HamPiRadio/HamPiRadio/(threads)

Thread 1 (2024-03-30):

Radio Board. Fix mixer LO low signal issue

chrisdebian, 2024-03-30:
**Describe the bug:**

The LO input is 7dBm (1.4Vpp) with the ring mixer disconnected. This must be over the frequency range 8 to 155MHz.

**Steps to reproduce:**

Disconnect the mixer LO pin. Measure with Oscilloscope (Vpp) or Spectrum Analyser (dBm). NOTE: Be aware that the scope has a highish input impedance and the SA a 50R input meaning that doing measurements can load the attenuator cursing the results. Also in my setup I have discovered my 100MHz scope probes are very low quality and once the signal is over 40MHz they attenuate a lor making them pretty useless for this measurement!

**Any thoughts on a solution to the problem?:**

Firstly, Getting an accurate measurement method is a must then ensuring the 2n3904 buffer/amplifier is suitable. It is I believe going to be ok for HF but for all frequencies I am doubting so a new design might be needed. Assistance from a good RF engineer is needed.

HamPiRadio, 2024-03-31:
Progress by Michael:
**Measurement method:** This of course has to be established first. The Spectrum Analyzer presents a 50R load to the circuit. To get an accurate measurement a quality probe is needed, and what works is a crimped SMA coax direct onto the circuit. This measure accurately using the tracking generator at  -20dBm , and also the Signal Generator set to the same.
**Requirement clarification:**  The post amplifier is driven at a high level into a Pi Attenuator that then feeds directly into the Double Balanced Mixer. I have changes the two 2N3904 devices to 2N2222a transistors (in parallel but with 12R emitter resistors) as they are higher current.  The reason for this is to reduce any noise. (Refer to the original OMEGA transceiver write-up for this).  **Results:** As of last night the 2 x 2N2222 devices are heating up!  Next to check the drive level again and the output loading...

chrisdebian, 2024-04-23:
Michael, please could you add a short status update, even if nothing has changed.

Many thanks,

Chris.

HamPiRadio, 2024-04-26:
I'm happy to. There has not been much progress recently apart from a) The work with yourself. b) Getting hampiradio.com up and running again. It is now secure. c) the radio-board-VFO thread on Discord. I have been doing a bit on this and the amp is now stable. As per the Discord thread there are a few components that need values to be decided on and a peer review or someone else to breadboard this would be great. d) the other issue (Rf Feedback) No progress as the VFO issue above MUST be sorted first. Thread on this is on Discord.
Software is stable and am very pleased with this. I will up load the UF2 soon.  Next CPU board is designed and laid out. Needs BOM and JLCPCB parts need adding and production. Front panel is also ready. The old and now removed Function rotary control are gone. Have added 3 SMD leds and removed the large hand mounted ones. They now fit on the Keypad PCB and I have found nice lenses that fit in front of the leds in the front panel.
PA and BPF boards are working fine, but I am / will be working on an iteration to manufacture them with as many smd parts as possible. Just needs time.

chrisdebian, 2024-04-26:
Hi, Michael.

Thanks for the update. On Discord, you shared some diagrams, would you be able to upload the relevant ones here? perhaps do the same for the other bug (no. 2)?

Cheers,

Chris.

HamPiRadio, 2024-04-27:
Oops, most of that update was not limited to the VFO issue! Apologies.

chrisdebian, 2024-04-27:
> Oops, most of that update was not limited to the VFO issue! Apologies.

Easily done, Michael. No worries.

Chris

HamPiRadio, 2024-04-27:
These are a copy of the pictures on Discord for this VFO thread. M
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

chrisdebian, 2024-04-27:
Thanks, Michael; that'll help the peer review.

Chris

HamPiRadio, 2024-04-28:
Morning Chris,  I uploaded the radio schematic. If you have kicad loaded you should see it, but there are some custom symbols I need to upload, so some of it won't look good. Can you check and email me corrected working on the bottom right please, about usage?Thank you.   Michael Sent from my Galaxy
-------- Original message --------From: chris_debian ***@***.***> Date: 28/04/24  11:02  (GMT+12:00) To: HamPiRadio/HamPiRadio ***@***.***> Cc: Michael Wise ***@***.***>, Assign ***@***.***> Subject: Re: [HamPiRadio/HamPiRadio] Radio Board. Fix mixer LO low signal issue (Issue #1)
Thanks, Michael; that'll help the peer review.
Chris

—Reply to this email directly, view it on GitHub, or unsubscribe.You are receiving this because you were assigned.Message ID: ***@***.***>

chrisdebian, 2024-04-28:
Hi, Michael.

I can install Kicad, but wasn't sure what you meant by "email me corrected working on the bottom right please"; could you clarify?

Thanks,

Chris

chrisdebian, 2024-04-28:
For consideration, and to be attributed if the originator would like:

"Consider replacing the 2N3904 and 2N2222A and use the BFR106.

Check out the ADE-6 for a DBM"

Thanks, P.

Chris

HamPiRadio, 2024-04-29:
Hi. The transistor is now a 2N2222a. The DBM device can either be a SBL-1 or an ADE-... device. That works well already. Thanks. MSent from my Galaxy
-------- Original message --------From: chris_debian ***@***.***> Date: 29/04/24  00:39  (GMT+12:00) To: HamPiRadio/HamPiRadio ***@***.***> Cc: Michael Wise ***@***.***>, Assign ***@***.***> Subject: Re: [HamPiRadio/HamPiRadio] Radio Board. Fix mixer LO low signal issue (Issue #1)
For consideration, and to be attributed if the originator would like:
"Consider replacing the 2N3904 and 2N2222A and use the BFR106.
Check out the ADE-6 for a DBM"
Thanks, P.
Chris

—Reply to this email directly, view it on GitHub, or unsubscribe.You are receiving this because you were assigned.Message ID: ***@***.***>

HamPiRadio, 2024-04-30:
The issue isn't the Si5351, 2N2222a or the Double Balanced Mixer.  It is getting the AMP levels correct and the attenuation matching as per my comments on Discord.

Thread 2 (2024-03-30):

Radio Board: Find / fix remaining (RF Feedback) issue.

chrisdebian, 2024-03-30:
**Describe the bug:**

RF feedback is upsetting the TX path. This is an introduced issue as it used to work well. It has been hard to chase and corner, but I believe the mixer is being overloaded in TX.

**Steps to reproduce:**

GO to TX in CW or SSB and increase TX drive, the power meter will show the transmitter ‘taking off’.

**Any thoughts on a solution to the problem?:**

Check in CW mode first and ensure the TX drive is correct into the mixer and not overloading it.

chrisdebian, 2024-04-23:
Michael, please could you add a short status update, even if nothing has changed.

Many thanks,

Chris.

HamPiRadio, 2024-04-27:
This is a copy of the picture on the Discord thread for this TX Buffer issue.
![Uploading TX pre mixer buffer.jpg…]()

Thread 4 (2024-03-31):

KiCad- Peer review of KiCad drawings

chrisdebian, 2024-03-31:
The KiCad drawings have been converted, but would benefit from peer review, to spot any potential issues.

https://docs.kicad.org/master/en/getting_started_in_kicad/getting_started_in_kicad.html#electrical_rules_check

and

https://docs.kicad.org/8.0/en/getting_started_in_kicad/getting_started_in_kicad.html#drc

Thread 13 (2024-04-23):

Add Schematics/ Gerber-type file to GitHub

chrisdebian, 2024-04-23:
Add Gerber-type files to GitHub sub-repositories (Thinking KiCad, PCBs/ Case/ enclosure drawings, etc?). What information has Michael got, that hasn’t been added/ moved to GitHub?

Thread 15 (2024-04-23):

PA Board- Check / convert to a SMD version made

chrisdebian, 2024-04-23:
1. Check / convert to a SMD version made. Create BOM &  get 5 manufactured by JLCPCB. (only hand built up to now. Some parts might change depending on availability from JLC and price. (Larger SMD parts like 2510 resistors)).

2. Decide on SMD I2Cs x 2 or leave as DIL. Probably leave as hand fit DIL as cheaper.  (LOW RISK just needs time)

Thread 19 (2024-04-23):

Case- Manufacturing

chrisdebian, 2024-04-23:
Case: Get a quantity manufactured, test design.

HamPiRadio, 2024-04-25:
The current design is workable, but it needs a very careful check to ensure all dimensions are correct before manufacturing more.  Ideas for an improved case would be good from others.

chrisdebian, 2024-04-25:
Thanks, Michael. Description updated.

Thread 20 (2024-04-23):

Add Iambic Keyer feature

chrisdebian, 2024-04-23:
Add iambic Keyer feature

#### Describe the requested feature:

Currently CW is ‘simple’. Hardware is already provided for a paddle Dit and Dah inputs to the microprocessor.

#### (If known) How would this be implemented?:

A software feature

Not in the initial release and the basic transceiver needs to be ‘a goer’. This addition is just a software enhancement. Added to Backlog.

Thread 23 (2024-04-23):

Update Si5351 drivers

chrisdebian, 2024-04-23:
Update Si5351 drivers and test

They are currently old, and there is now an Arduino library that can be used.

HamPiRadio, 2024-04-25:
All currently working fine, so this is just a nice to have to tidy things up.

chrisdebian, 2024-04-25:
Great, we could probably move this from the distant Milestone 4, to something nearer after MVP (Milestone 1). We can reassess all milestones after the initial release.

Chris.

HamPiRadio, 2024-04-26:
I agree. It's 'nice to have' and non urgent and non important. M

HamPiRadio, 2024-04-29:
It would be a dream except the minimum output frequency needs to be 8MHz + 160kHz (IF+lowest band)Si570 output frequency from 10 to 945 MHzThe SI5351 is fine I believe.  The issue is only about the VFO amp and attenuator.  It's nearly there, I'm just testing it out, and would love one or two others to breadboard it.MSent from my Galaxy
-------- Original message --------From: chris_debian ***@***.***> Date: 29/04/24  00:27  (GMT+12:00) To: HamPiRadio/HamPiRadio ***@***.***> Cc: Michael Wise ***@***.***>, Comment ***@***.***> Subject: Re: [HamPiRadio/HamPiRadio] Update Si5351 drivers (Issue #23)
Would the Si570 be a better option, than the Si5351? Pros/ cons?
Chris

—Reply to this email directly, view it on GitHub, or unsubscribe.You are receiving this because you commented.Message ID: ***@***.***>

Thread 24 (2024-04-23):

Incorporate CW Decode Software

chrisdebian, 2024-04-23:
CW decode software could be added as a feature and display CW on the TFT and / or ‘pipe it’  using USB to a host PC. This will display the received CW in plaintext ASCII as it is being received.

Thread 9 (2024-04-23):

Add HamPiRadio firmware to GitHub

chrisdebian, 2024-04-23:
Make HamPiRadio code available from GitHub. Binary/ code/ both?

Document notes, [here](https://github.com/HamPiRadio/HamPiRadio/wiki/HamPi-Firmware)?

HamPiRadio, 2024-04-26:
Are you wanting me to just attach files here Chris? If so no worries...

chrisdebian, 2024-04-26:
It would be great if the firmware could be uploaded, or binaries. This would be a huge achievement in moving the project forward. it is easy to upload, using the ['Upload' button](https://docs.github.com/en/repositories/working-with-files/managing-files/adding-a-file-to-a-repository), or perhaps from the GitHub [Desktop ](https://desktop.github.com/)app.

The project is here to help, although I know that is only me, right now, but that could change, today, and will change definitely, very soon.

Thanks,

Chris.

Thread 27 (2024-04-29):

Create editable build manual

chrisdebian, 2024-04-29:

HamPiRadio, 2024-04-30:
Currently this is a document for each board (4), and changes each time there is a new PCB. It is basic with no frills, but follow-able I think!  The Radio Board one also has instructions for setting up the software for the Radio Board (For example the IF has to be swung and set into E2PROM for the XTAL Filter frequencies, BOTH SSB & CW filters).

chrisdebian, 2024-04-30:
Hi, Michael.

yes, please upload any documentation, that you have, to the relevant part of the [Wiki](https://github.com/HamPiRadio/HamPiRadio/wiki). Please upload in an editable format, rather than a locked PDF. We can unlock a PDF, but the idea is not to discourage participation.

Thanks,

Chris.

HamPiRadio, 2024-05-04:
Upload to here? M

chrisdebian, 2024-05-04:
Hi, Michael. Could you upload to the Wiki, perhaps [here](https://github.com/HamPiRadio/HamPiRadio/wiki/Construction)?

Thanks,

Chris

Thread 28 (2024-05-01):

Document settings for QRP operation.

chrisdebian, 2024-05-01:
Many kit builders are QRP practitioners. Make it clear in the Wiki, and the Operating Manual document, how the transceiver is configured to operate QRP.

Chris.

HamPiRadio, 2024-05-01:
For any QRP builder the setup is essentially the same, but without the finals fitted.  Knowing QRP people however they can experiment and minimize the HamPiRario to any extent they like. I could only suggest! Single band, single BPF and LPF, Lower power LPF. Own case. It would be an exceptional rig as well.  I guess for any devoted QRP people the PA board can be de-featured and a lower power version created. Not a lot of work.  I can guide but not do on this one...
For people getting involved 'right now' and getting the main bits working on the bench, suggest buying the RADIO + CPU + KEYPAD boards with SMD fitted and build them. In this form the receiver will work and the TX section to the RF after the mixer. Any old BPF can be fitted by hand for listening...
