HamPiRadio/HamPiRadio/Radio_7_SM.kicad_sch

## KiCad design Radio_7_SM.kicad_sch (2024-04-28)

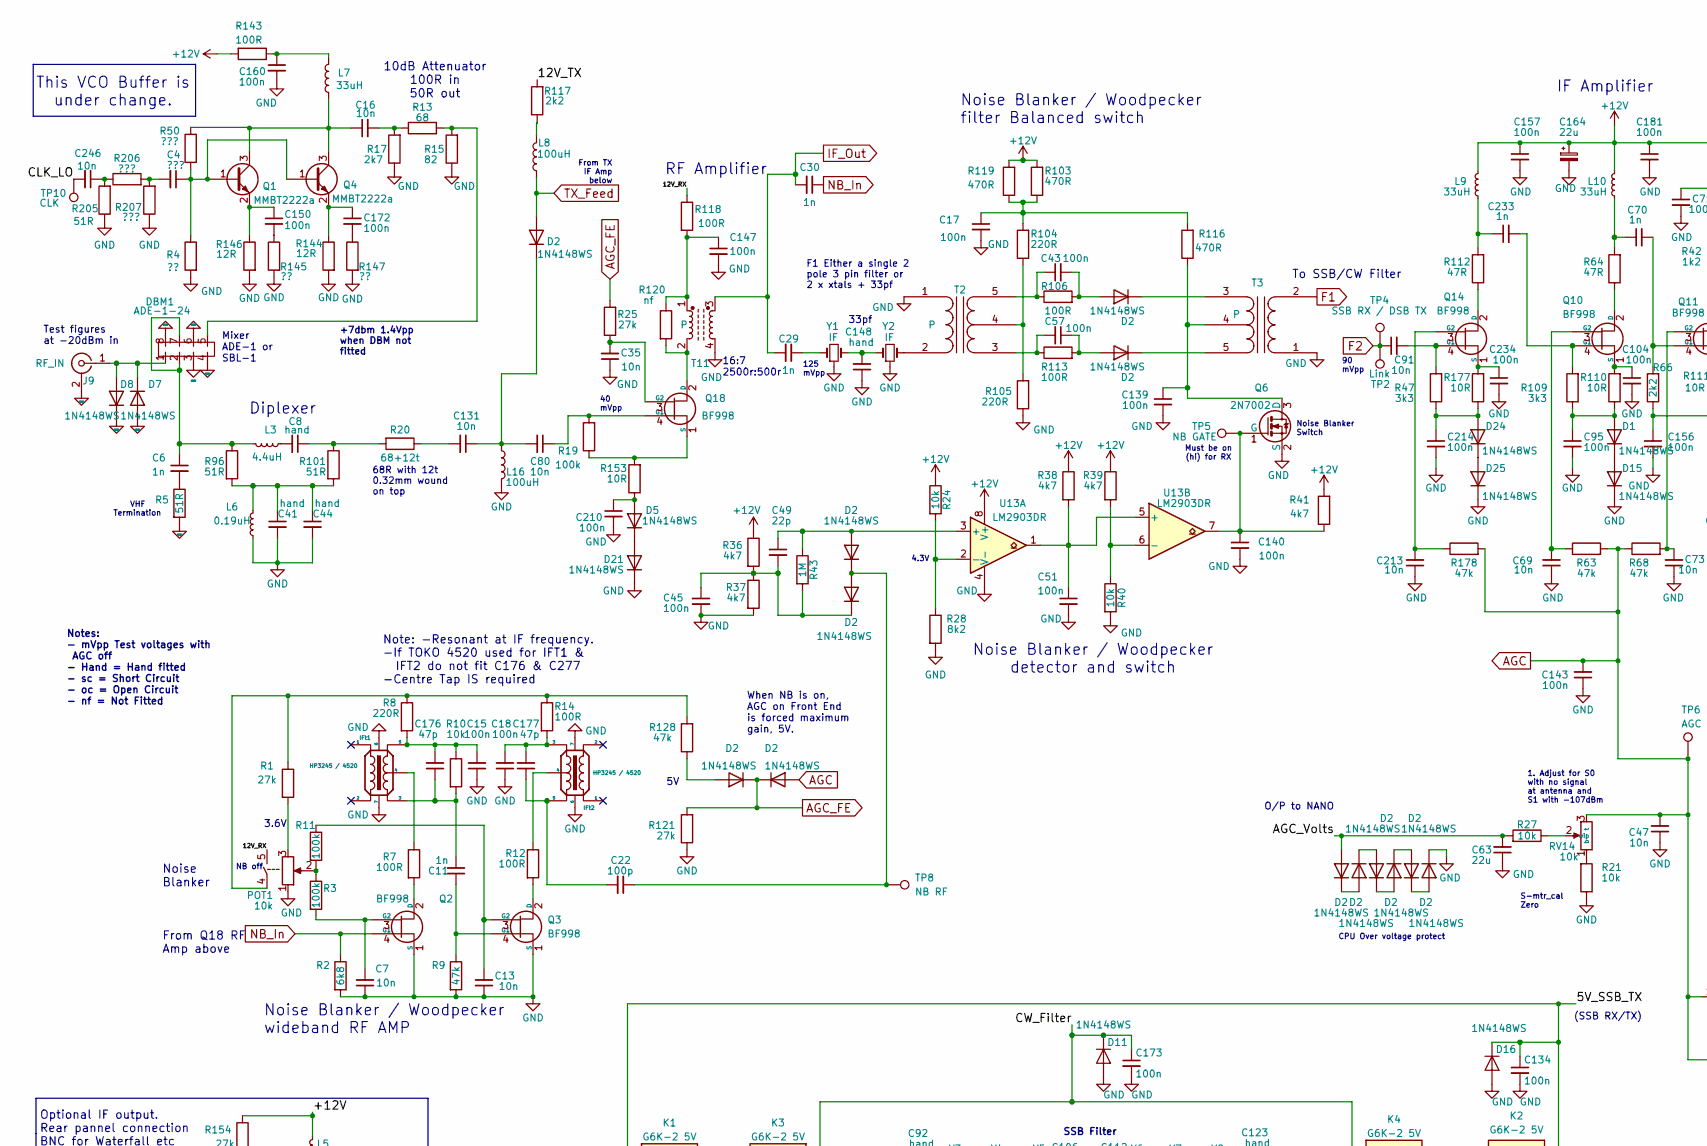
[picture p1: schematic Radio_7_SM.kicad_sch, part in row 1, column 1]

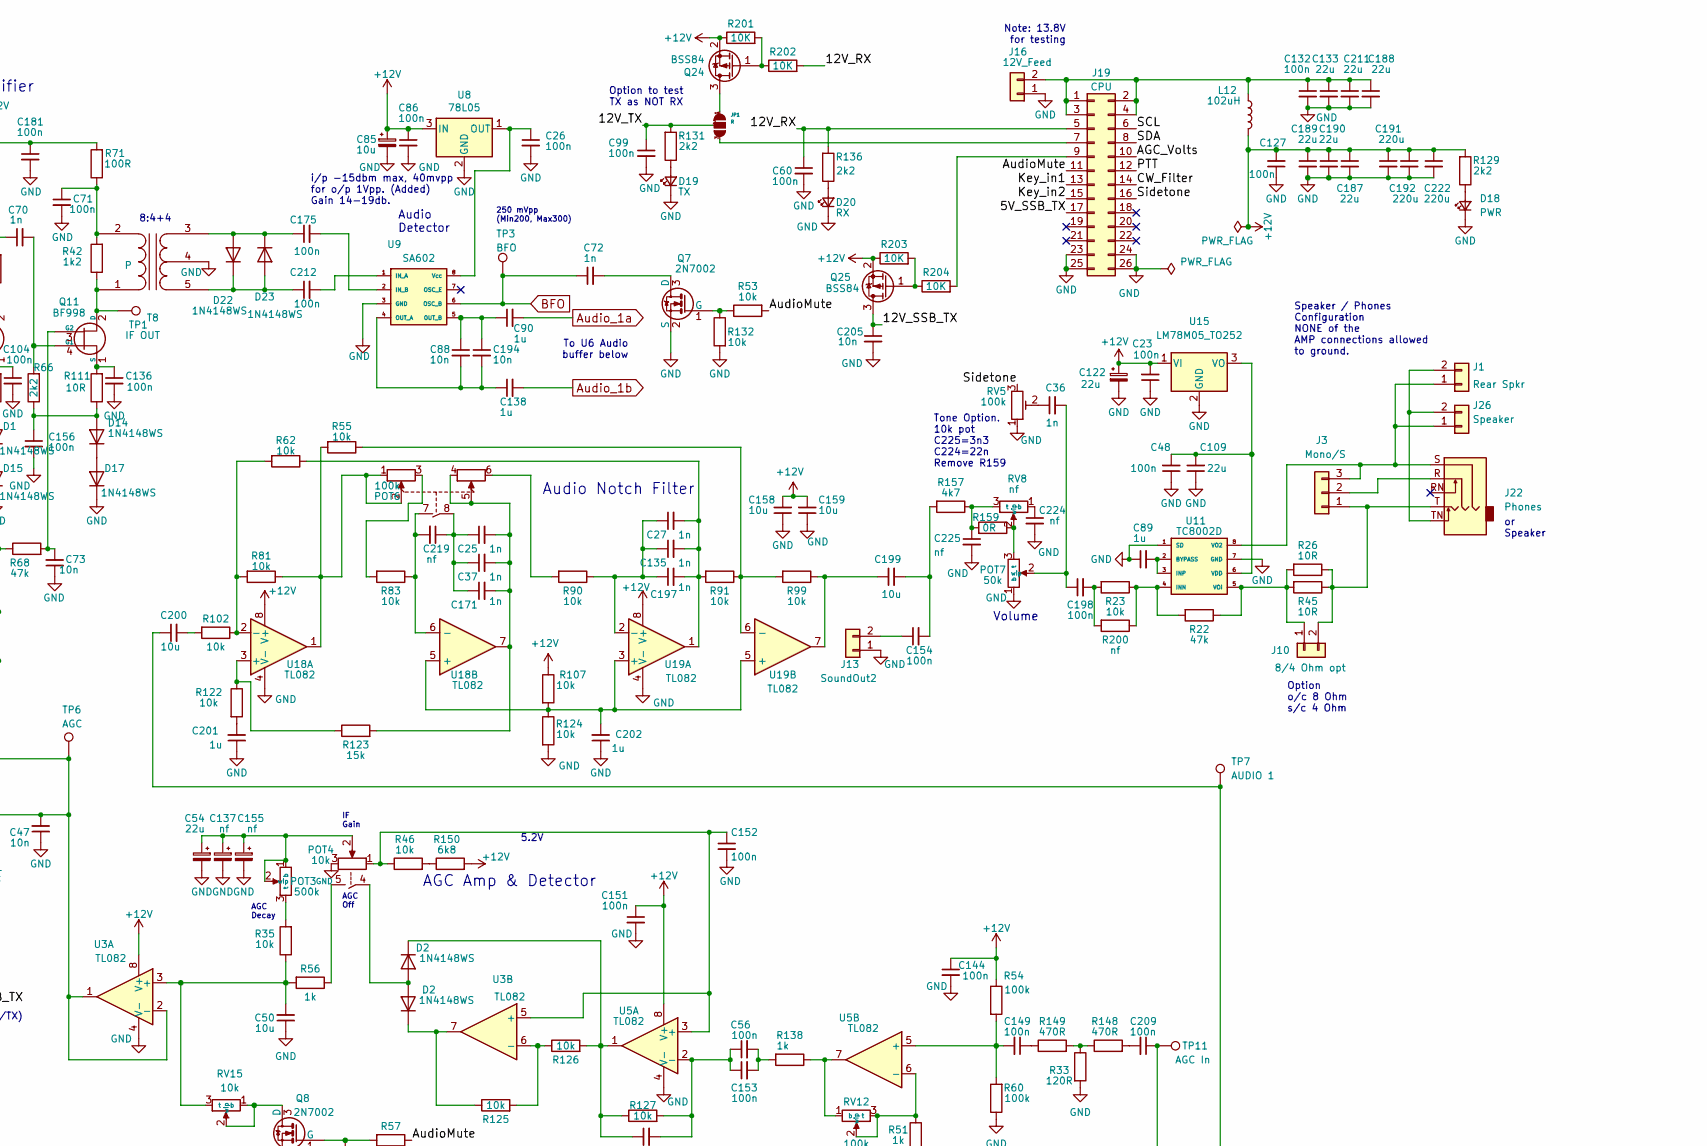
[picture p2: schematic Radio_7_SM.kicad_sch, part in row 1, column 2]

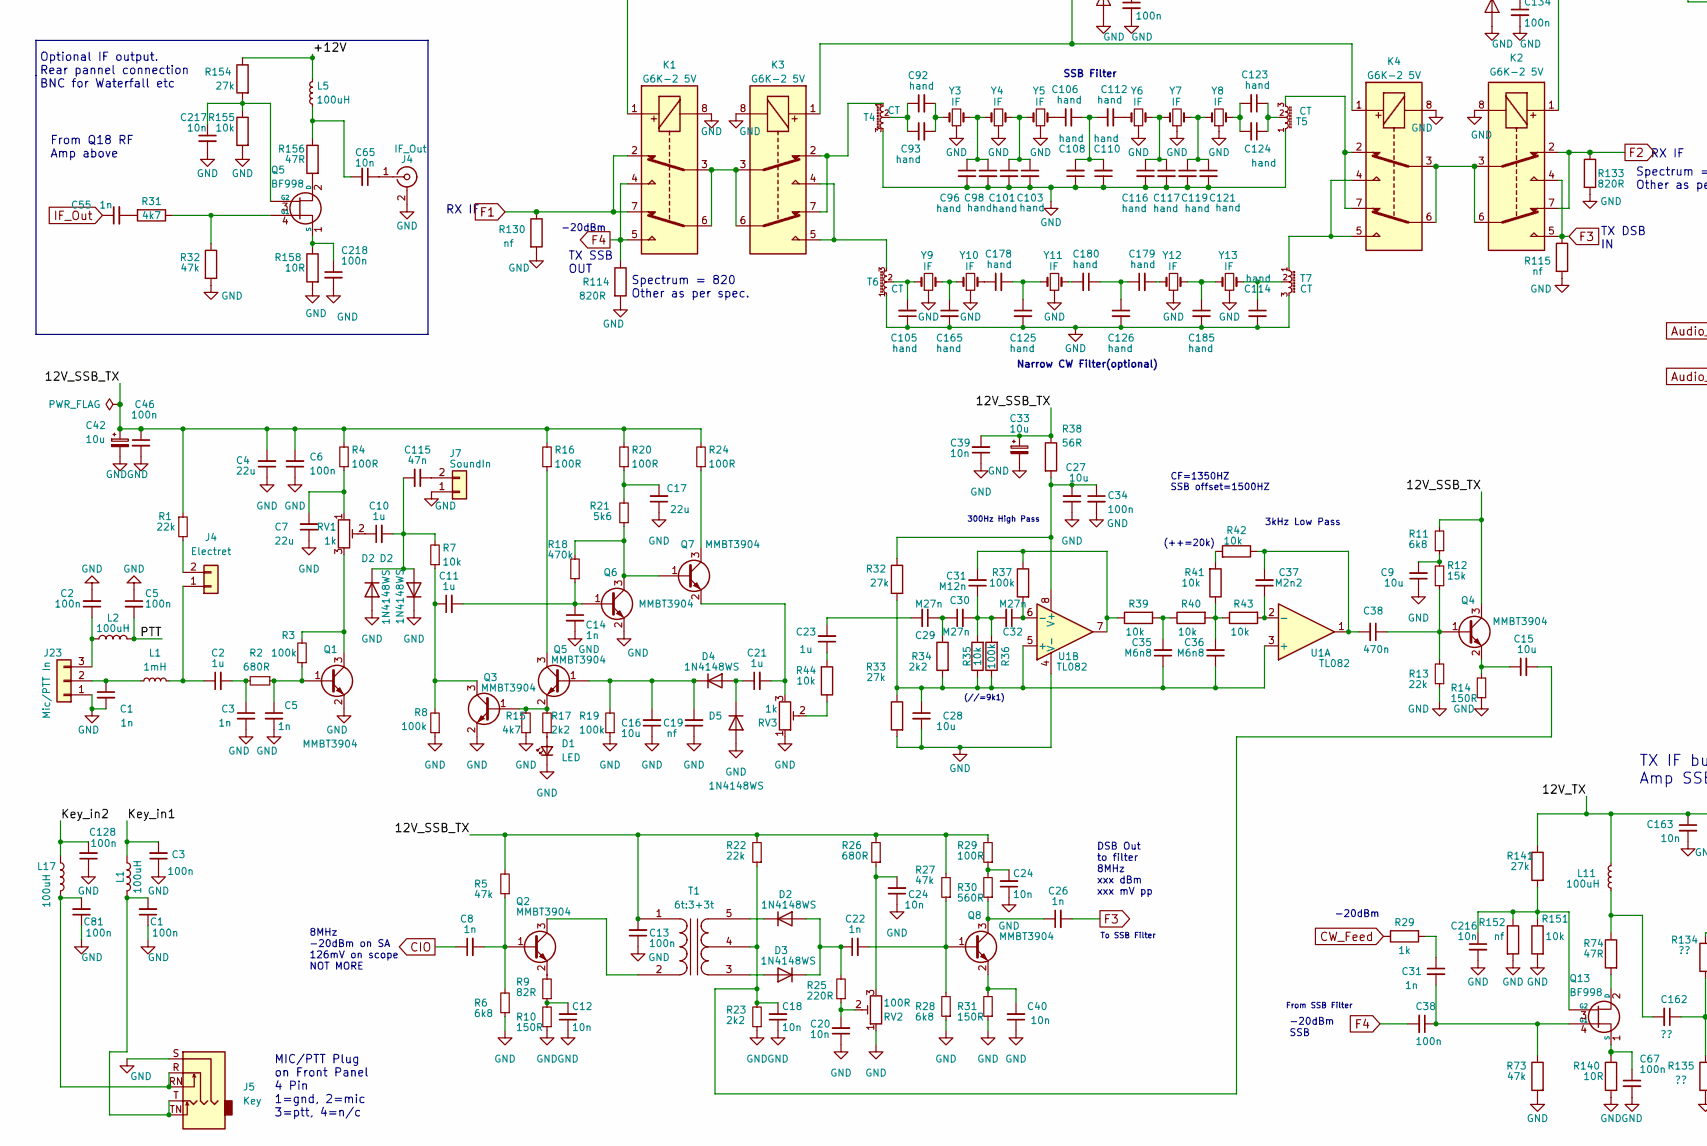
[picture p3: schematic Radio_7_SM.kicad_sch, part in row 2, column 1]

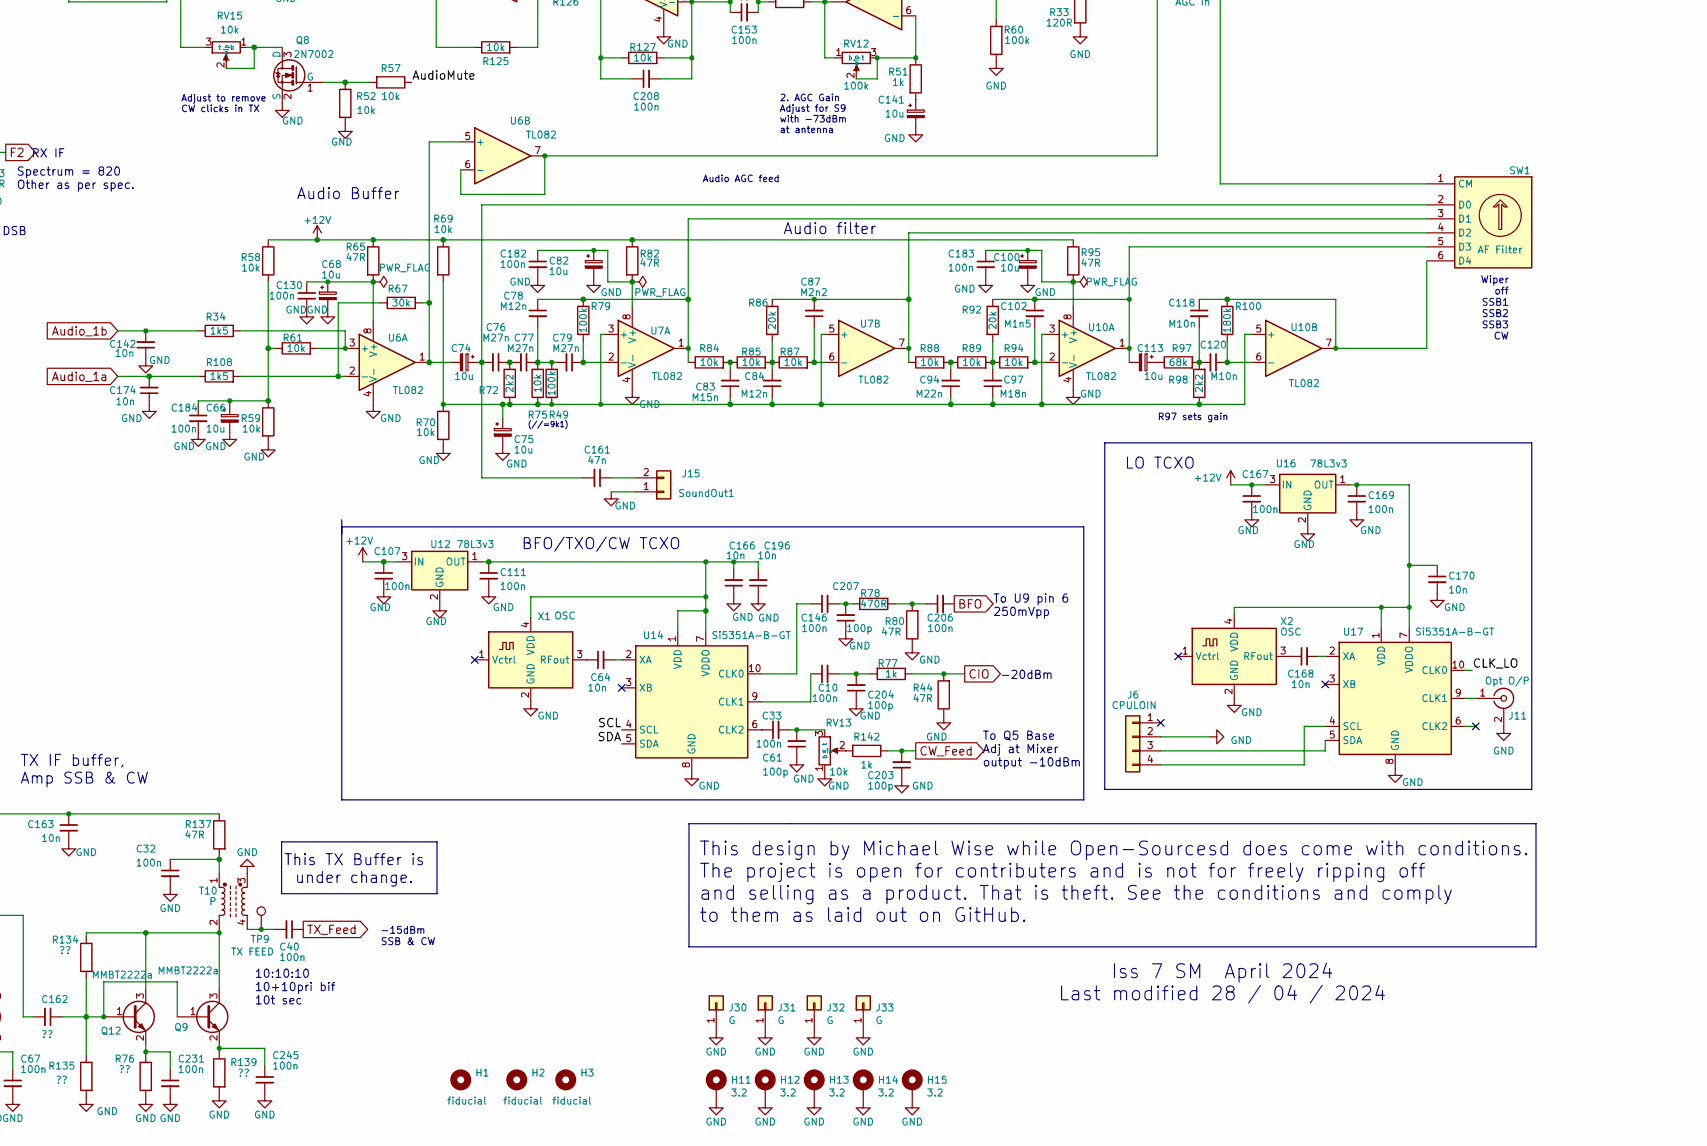
[picture p4: schematic Radio_7_SM.kicad_sch, part in row 2, column 2]

Parts:
C1, C2, C5, C10, C15, C17, C18, C23, C26, C33, C34, C38, C40, C43, C45, C46, C48, C51, C56, C57, C60, C67, C71, C81, C86, C95, C99, C104, C107, C111, C127, C128, C130, C132, C134, C136, C139, C140, C143, C144, C146, C147, C149, C150, C151, C152, C153, C154, C156, C157, C160, C167, C169, C172, C173, C175, C181, C182, C183, C184, C198, C206, C208, C209, C210, C212, C214, C218, C231, C234, C245: 100n; C_0805_2012Metric; PartNum C28233
C3, C6, C11, C14, C25, C27, C30, C31, C36, C55, C70, C72, C135, C171, C197, C233: 1n; C_0805_2012Metric; PartNum C46653
C4, C54, C63, C109, C122, C133, C164, C187, C188, C189, C190, C211: 22u; C_0805_2012Metric; PartNum C45783
C7, C12, C13, C20, C24, C35, C39, C47, C64, C65, C69, C73, C80, C88, C91, C131, C142, C163, C166, C168, C170, C174, C194, C196, C205, C213, C216, C217: 10n; C_0805_2012Metric; PartNum C1710
C8, C41, C44, C92, C93, C96, C98, C101, C103, C105, C106, C108, C110, C112, C114, C116, C117, C119, C121, C123, C124, C125, C126, C148, C165, C178, C179, C180, C185: hand; C_Disc_2.5_5mm_HamPi
C9, C28, C42, C50, C66, C68, C74, C75, C82, C85, C100, C113, C141, C158, C159, C199, C200: 10u; C_0805_2012Metric; PartNum C440198
C16: 10n; C_0805_2012Metric; PartNum C53134
C19, C137, C155, C219, C224, C225: nf; C_0805_2012Metric
C21, C89, C90, C138, C201, C202: 1u; C_0805_2012Metric; PartNum C28323
C22, C61, C203, C204, C207: 100p; C_0805_2012Metric; PartNum C1790
C29, C32, C76, C77, C79: M27n; C_Disc_2.5_4mm_HamPi
C37, C87: M2n2; C_Disc_2.5_4mm_HamPi
C49: 22p; C_0805_2012Metric; PartNum C1804
C78, C84: M12n; C_Disc_2.5_4mm_HamPi
C83: M15n; C_Disc_2.5_4mm_HamPi
C94: M22n; C_Disc_2.5_4mm_HamPi
C97: M18n; C_Disc_2.5_4mm_HamPi
C102: M1n5; C_Disc_2.5_4mm_HamPi
C115, C161: 47n; C_0805_2012Metric; PartNum C53134
C118, C120: M10n; C_Disc_2.5_4mm_HamPi
C162: ??; C_0805_2012Metric; PartNum C28233
C176, C177: 47p; C_0805_2012Metric; PartNum C14857
C191, C192, C222: 220u; CP_Radial_D6.3mm_P2.50mm
C246: 10n; C_0805_2012Metric; PartNum C46653
D1, D2, D3, D4, D5, D7, D8, D11, D14, D15, D16, D17, D21, D22, D23, D24, D25: 1N4148WS; D_SOD-323_HandSoldering; PartNum C2128
D18: PWR; D_0805_2012Metric_Pad1.15x1.40mm_HandSolder; PartNum C84256
D19: TX; D_0805_2012Metric_Pad1.15x1.40mm_HandSolder; PartNum C2286
D20: RX; D_0805_2012Metric_Pad1.15x1.40mm_HandSolder; PartNum C2297
DBM1: ADE-1-24; DBM
H1, H2, H3: fiducial; Fiducial_1.152mm_Mask1.3mm
H11, H12, H13, H14, H15: 3.2; MountingHole_3.2mm_M3_Pad_Via
IFt1, IFt2: HP3245 / 4520; TOKO_t_mod
J1: Rear Spkr; PinHeader_Vertical_Surround
J3: Mono/S; PinHeader_1x03_P2.54mm_Vertical
J4: IF_Out; SMB_Jack_Vertical
J5: Key; Jack_3.5mm_Ledino_KB3SPRS_Horizontal
J6: CPULOIN; HamPi_PinHeader_1x04_P2.54mm_Vertical
J7: SoundIn; PinHeader_1x02_P2.54mm_Vertical
J9: RF_IN; SMB_Jack_Vertical
J10: 8/4 Ohm opt; PinHeader_1x02_P2.54mm_Vertical
J11: Opt O/P; SMB_Jack_Vertical
J13: SoundOut2; PinHeader_Vertical_Surround
J15: SoundOut1; PinHeader_Vertical_Surround
J16: 12V_Feed; PinHeader_Vertical_Surround
J19: CPU; Pin_Header_Straight_2x13_Pitch2.54mm_HamPi
J22: Phones; Jack_3.5mm_Ledino_KB3SPRS_Horizontal
J23: Mic/PTT In; PinHeader_Vertical_Surround_3
J26: Speaker; PinHeader_Vertical_Surround
J30, J31, J32, J33: G; Pin_D0.7mm_L6.5mm_W1.8mm_FlatFork
JP1: R; SolderJumper-3_P1.3mm_Open_RoundedPad1.0x1.5mm_NumberLabels
K1, K2, K3, K4: G6K-2 5V; Relay_DPDT_Omron_G6K-2F-Y; PartNum C47190
L1, L2, L5, L8, L11, L16, L17: 100uH; HP_L_1210_3225Metric_Pad1.42x2.65mm_HandSolder; PartNum C307784
L3: 4.4uH; L_Toroid_Vertical_Tiedown_custom
L6: 0.19uH; L_Toroid_Vertical_Tiedown_Special
L7: 33uH; HP_L_1210_3225Metric_Pad1.42x2.65mm_HandSolder; PartNum C307784
L9, L10: 33uH; HP_L_1210_3225Metric_Pad1.42x2.65mm_HandSolder
L12: 102uH; HamPi L14mm_W6.00mm
POT1, POT4: 10k; Potentiometer_Alps_RK097_Single_Horizontal_Switch
POT3: 500k; Potentiometer_Alps_RK09Y11_Single_Horizontal
POT6: 100k; Potentiometer_Alps_RK097_Dual_Horizontal_Switch
POT7: 50k; Potentiometer_Alps_RK09Y11_Single_Horizontal
Q1: MMBT3904; SOT-23; PartNum C20526
Q2, Q3, Q5, Q10, Q11, Q13, Q14, Q18: BF998; SOT-143_Handsoldering; PartNum C108141
Q4, Q9, Q12: MMBT2222a; SOT-23; PartNum C20526
Q6, Q7, Q8: 2N7002; SOT-23; PartNum C8545
Q24, Q25: BSS84; SOT-23; PartNum C15127
R1, R25, R121, R141, R154: 27k; R_0805_2012Metric; PartNum C17593
R2, R6, R150: 6k8; R_0805_2012Metric; PartNum C17772
R3, R11, R19, R49, R54, R60, R79: 100k; R_0805_2012Metric; PartNum C149504
R4, R7, R12, R14, R16, R71, R106, R113, R118, R143: 100R; R_0805_2012Metric; PartNum C17408
R5, R96, R101: 51R; R_0805_2012Metric; PartNum C17738
R8, R104, R105: 220R; R_0805_2012Metric; PartNum C17557
R9, R32, R63, R68, R73, R128, R178: 47k; R_0805_2012Metric; PartNum C17713
R10, R21, R24, R35, R40, R44, R46, R52, R53, R55, R57, R58, R59, R61, R62, R69, R70, R75, R81, R83, R84, R85, R87, R88, R89, R90, R91, R94, R99, R102, R107, R122, R124, R125, R126, R127, R132, R151, R155: 10k; R_0805_2012Metric; PartNum C17414
R13: 68; R_0805_2012Metric; PartNum C17634
R15, R31, R36, R37, R38, R39, R41, R157: 4k7; R_0805_2012Metric; PartNum C17673
R17: 2k7; R_0805_2012Metric; PartNum C17471
R18: 470k; R_0805_2012Metric; PartNum C17709
R20: 68+12t; R_Axial_DIN0207_L6.3mm_D2.5mm_P7.62mm_Horizontal
R22: 22k; R_0805_2012Metric; PartNum C17560
R23, R66, R72, R98, R117, R129, R131, R136: 2k2; R_0805_2012Metric; PartNum C17520
R26: 680R; R_0805_2012Metric; PartNum C23253
R27: 10k; R_0805_2012Metric; PartNum C17477
R28: 8k2; R_0805_2012Metric; PartNum C17828
R29, R51, R56, R77, R138, R142: 1k; R_0805_2012Metric; PartNum C17513
R30: 560R; R_0805_2012Metric; PartNum C28636
R33: 120R; R_0805_2012Metric; PartNum C17437
R34, R108: 1k5; R_0805_2012Metric; PartNum C4310
R42: 1k2; R_0805_2012Metric; PartNum C17379
R43: 1M; R_0805_2012Metric; PartNum C17514
R45, R110, R111, R140, R153, R158, R177: 10R; R_0805_2012Metric; PartNum C17415
R47, R109: 3k3; R_0805_2012Metric; PartNum C26010
R50: ???; R_0805_2012Metric; PartNum C17475
R64, R65, R74, R80, R82, R95, R112, R137, R156: 47R; R_0805_2012Metric; PartNum C17714
R67: 30k; R_0805_2012Metric; PartNum C17621
R76, R139: ??; R_0805_2012Metric; PartNum C17408
R78, R103, R116, R119, R148, R149: 470R; R_0805_2012Metric; PartNum C17710
R86, R92: 20k; R_0805_2012Metric; PartNum C4328
R97: 68k; R_0805_2012Metric; PartNum C17801
R100: 180k; R_0805_2012Metric; PartNum C17501
R114, R133: 820R; R_0805_2012Metric; PartNum C23253
R115, R120, R130, R152, R200: nf; R_0805_2012Metric
R123: 15k; R_0805_2012Metric; PartNum C17475
R134: ??; R_0805_2012Metric; PartNum C17633
R135: ??; R_0805_2012Metric; PartNum C17673
R144, R146: 12R; R_0805_2012Metric; PartNum C17714
R145, R147: ??; R_0805_2012Metric; PartNum C17415
R159: 0R; R_0805_2012Metric; PartNum C17477
R201, R202, R203, R204: 10K; R_0805_2012Metric; PartNum C17414
R205: 51R; R_0805_2012Metric; PartNum C17471
R206: ???; R_0805_2012Metric; PartNum C17634
R207: ???; R_0805_2012Metric; PartNum C17471
RV1, RV3: 1k; Potentiometer_Bourns_TC33X_Vertical; PartNum C719174
RV2: 100R; Potentiometer_Bourns_TC33X_Vertical; PartNum C911390
RV5, RV12: 100k; Potentiometer_Bourns_TC33X_Vertical; PartNum C719186
RV8: nf; Potentiometer_Bourns_TC33X_Vertical
RV13, RV14, RV15: 10k; Potentiometer_Bourns_TC33X_Vertical; PartNum C719176
SW1: AF Filter; RS1010_1x5_Rot_Switch
T1: 6t:3+3t; Ferite5
T2, T3, T8: P; Ferite5
T4, T5, T6, T7: CT; Ferite_PA_3pin_vert
T10, T11: P; Ferrite4
TP1: IF OUT; TestPoint_2.0x2.0mm_Drill1.25mm
TP2: Link; TestPoint_THTPad_D1.5mm_Drill0.7mm
TP3: BFO; TestPoint_2.0x2.0mm_Drill1.25mm
TP4: SSB RX / DSB TX; TestPoint_THTPad_D1.5mm_Drill0.7mm
TP5: NB GATE; TestPoint_2.0x2.0mm_Drill1.25mm
TP6: AGC; TestPoint_2.0x2.0mm_Drill1.25mm
TP7: AUDIO 1; TestPoint_2.0x2.0mm_Drill1.25mm
TP8: NB RF; TestPoint_2.0x2.0mm_Drill1.25mm
TP9: TX FEED; TestPoint_2.0x2.0mm_Drill1.25mm
TP10: CLK; TestPoint_2.0x2.0mm_Drill1.25mm
TP11: AGC In; TestPoint_2.0x2.0mm_Drill1.25mm
U1, U3, U5, U6, U7, U10, U18, U19: TL082; SOP-8_3.9x4.9mm_P1.27mm; PartNum C6961
U8: 78L05; SOT-89-3; PartNum C71136
U9: SA602; SOP-8_3.9x4.9mm_P1.27mm
U11: TC8002D; SOP-8_3.9x4.9mm_P1.27mm; PartNum C87265
U12, U16: 78L3v3; SOT-89-3; PartNum C14170
U13: LM2903DR; SOP-8_3.9x4.9mm_P1.27mm; PartNum C7549
U14, U17: Si5351A-B-GT; MSOP-10_3x3mm_P0.5mm; PartNum C504891
U15: LM78M05_TO252; TO-252-2; PartNum C58069
X1, X2: OSC; Crystal_SMD_5032-4Pin_5.0x3.2mm; PartNum C5452698
Y1, Y2, Y3, Y4, Y5, Y6, Y7, Y8, Y9, Y10, Y11, Y12, Y13: IF; Crystal_HC49-U_Vertical_HamPi

Connections:
5V_SSB_TX: C134.1, D16.1 (K), J19.17, K1.1, K2.1
12V_RX: C60.1, J19.5, POT1.5, R118.1, R136.2, R202.2
12V_SSB_TX: C4.2, C6.2, C13.2, C33.1, C39.2, C42.1, C46.1, C205.1, Q4.3 (C), Q25.3 (D), R1.1, R4.2, R5.2, R11.2, R16.2, R20.2, R22.2, R24.2, R26.2, R27.2, R29.2, R38.1, T1.1 (AA)
12V_TX: C99.1, C163.1, JP1.2 (C), L11.2, R117.2, R131.2, R137.1, R141.1
+12V: C23.2, C85.1, C86.1, C107.1, C122.1, C127.2, C144.1, C151.1, C157.1, C158.2, C159.2, C164.1, C167.1, C181.1, C187.1, C189.1, C190.1, C191.1, C192.1, C222.1, L5.2, L9.2, L10.2, L12.2, Q24.2 (S), Q25.2 (S), R24.1, R36.1, R38.1, R39.1, R41.2, R54.1, R58.1, R65.1, R69.1, R71.2, R82.1, R95.1, R103.2, R107.1, R119.2, R129.2, R143.2, R150.2, R154.1, R201.1, R203.1, U3.8 (V+), U5.8 (V+), U8.3 (IN), U12.3 (IN), U13.8 (V+), U15.1 (VI), U16.3 (IN), U18.8 (V+), U19.8 (V+)
AGC: C47.2, C143.2, D2.2 (A), R63.2, R68.1, R178.2, RV14.3 (t), TP6.1, U3.1, U3.2 (-)
AGC_FE: D2.1 (K), R25.2, R121.2
AGC_Volts: C63.2, D2.2 (A), J19.10, R27.2
AudioMute: J19.11, R53.2, R57.1
Audio_1a: C90.2, C174.2, R108.1
Audio_1b: C138.2, C142.2, R34.1
BFO: C72.1, C206.2, TP3.1, U9.6 (OSC_B)
CIO: C8.1, R44.2, R77.1
CLK_LO: C246.2, TP10.1, U17.10 (CLK0)
CW_Feed: C203.2, R29.1, R142.1
CW_Filter: C173.1, D11.1 (K), J19.14, K3.1, K4.1
F1: K1.2, K1.7, R130.1, T3.2 (AB)
F2: C91.1, K2.2, K2.7, R133.1, TP2.1, TP4.1
F3: C26.2, K2.4, K2.5, R115.1
F4: C38.2, K1.4, K1.5, R114.1
GND: C1.1, C1.2, C2.2, C3.1, C3.2, C4.1, C5.1, C5.2, C6.1, C7.1, C9.1, C12.1, C13.1, C14.2, C15.1, C16.1, C17.1, C17.2, C18.1, C19.1, C20.1, C23.1, C24.1, C26.2, C27.1, C28.2, C32.2, C33.2, C34.2, C35.1, C39.1, C40.1, C41.2, C42.2, C44.2, C45.2, C46.2, C47.1, C48.1, C50.1, C51.2, C54.2, C60.2, C61.1, C63.1, C66.2, C67.2, C68.2, C69.1, C71.2, C73.1, C75.2, C81.1, C82.2, C85.2, C86.2, C89.1, C95.2, C96.2, C98.2, C99.2, C100.2, C101.2, C103.2, C104.2, C105.1, C107.2, C108.1, C109.1, C110.1, C111.2, C114.2, C116.2, C117.2, C119.2, C121.2, C122.2, C125.2, C126.2, C127.1, C128.1, C130.2, C132.2, C133.2, C134.2, C136.2, C137.2, C139.2, C140.2, C141.2, C142.1, C143.1, C144.2, C147.2, C148.1, C151.2, C152.2, C155.2, C156.2, C157.2, C158.1, C159.1, C160.2, C163.2, C164.2, C165.2, C166.1, C167.2, C169.2, C170.2, C173.2, C174.1, C181.2, C182.2, C183.2, C184.2, C185.2, C187.2, C188.2, C189.2, C190.2, C191.2, C192.2, C196.1, C201.1, C202.1, C203.1, C204.1, C205.2, C207.1, C210.2, C211.2, C213.1, C214.2, C216.2, C217.2, C218.2, C222.2, C224.2, C225.2, C231.2, C234.2, C245.2, D1.1 (K), D2.1 (K), D2.2 (A), D5.2 (A), D7.1 (K), D8.2 (A), D11.2 (A), D15.1 (K), D16.2 (A), D17.1 (K), D18.1 (K), D19.1 (K), D20.1 (K), D21.1 (K), D25.1 (K), DBM1.3, DBM1.4, DBM1.6, DBM1.8, H11.1, H12.1, H13.1, H14.1, H15.1, IFt1.6, IFt1.7, IFt2.6, IFt2.7, J4.2, J5.S, J6.2, J7.1, J9.2 (Ext), J11.2 (Ext), J13.1, J15.1, J16.1, J19.23, J19.24, J19.25, J19.26, J23.1, J30.1, J31.1, J32.1, J33.1, K1.8, K2.8, K3.8, K4.8, L6.1, L16.2, POT1.1, POT4.3, POT7.1 (b), Q1.2 (E), Q2.1 (B), Q3.1 (B), Q3.2 (E), Q6.2 (E), Q7.2 (E), Q8.2 (E), R2.2, R4.2, R5.2, R6.1, R8.1, R9.2, R10.1, R13.1, R14.1, R15.1, R17.1, R19.1, R21.1, R23.1, R28.1, R28.2, R31.1, R32.2, R33.2, R37.2, R40.2, R44.1, R52.2, R59.2, R60.1, R70.2, R73.2, R76.2, R80.1, R105.1, R114.2, R115.2, R121.1, R124.2, R130.2, R132.2, R133.2, R135.2, R139.2, R140.2, R144.2, R145.2, R146.2, R147.2, R151.2, R152.2, R155.2, R158.2, R205.1, R207.1, RV2.1, RV3.1, RV5.1, RV13.1 (b), T2.1 (AA), T3.1 (AA), T4.3, T5.1, T6.1, T7.3, T8.4 (SC), T10.3, T11.4, U1.4 (V-), U3.4 (V-), U5.4 (V-), U6.4 (V-), U7.4 (V-), U8.2 (GND), U9.3 (GND), U10.4 (V-), U11.1 (SD), U11.7 (GND), U12.2 (GND), U13.4 (V-), U14.8 (GND), U15.2 (GND), U16.2 (GND), U17.8 (GND), U18.4 (V-), U19.4 (V-), X1.2 (GND), X2.2 (GND), Y1.3 (2), Y2.3 (2), Y3.3 (2), Y4.3 (2), Y5.3 (2), Y6.3 (2), Y7.3 (2), Y8.3 (2), Y9.3 (2), Y10.3 (2), Y11.3 (2), Y12.3 (2), Y13.3 (2)
IF_Out: C29.2, C30.2, C55.1, T11.3
Key_in1: C3.2, J19.13, L1.1
Key_in2: C128.2, J19.15, L17.1
NB_In: C30.1, Q2.4 (G1), R2.1
unnamed: C1.1, J23.2, L1.1
unnamed: C1.2, J5.T, J5.TN, L1.2
unnamed: C2.1, J4.1, J23.3, L1.2, L2.2
unnamed: C2.2, C3.1, R2.2
unnamed: C4.1, Q1.1 (B), Q4.1 (B), R4.1, R50.2
unnamed: C4.2, R206.2, R207.2
unnamed: C5.1, Q1.1 (B), R2.1, R3.1
unnamed: C6.1, DBM1.2, DBM1.7, L3.1, R96.1
unnamed: C6.2, R5.1
unnamed: C7.2, Q2.3 (C), R3.2, R4.1, RV1.1
unnamed: C8.1, R20.2, R101.1
unnamed: C8.2, L3.2, Q2.1 (B), R5.1, R6.2
unnamed: C9.2, R11.1, R12.2
unnamed: C10.1, RV1.2, U14.9 (CLK1)
unnamed: C10.2, C115.2, C204.2, D2.1 (K), D2.2 (A), R7.2, R77.2
unnamed: C11.1, Q3.3 (C), Q3.4 (G1), R7.1, R8.2, R9.1
unnamed: C11.2, C14.1, C176.1, IFt1.3, Q6.1 (B), R10.2, R18.1
unnamed: C12.2, R9.1, R10.2
unnamed: C13.2, Q3.3 (C), R11.1
unnamed: C15.1, Q4.2 (E), R14.2
unnamed: C15.2, C18.2, C176.2, IFt1.5, R8.2, R10.1, R22.1, R23.2, T1.4 (SC)
unnamed: C16.1, L7.1, Q1.3 (C), Q4.3 (C), R50.1
unnamed: C16.2, C19.2, D4.1 (K), Q5.1 (B), R13.1, R17.2, R19.2
unnamed: C17.1, R103.1, R104.2, R116.2, R119.1
unnamed: C17.2, R20.1, R21.2
unnamed: C20.2, R25.1, RV2.2
unnamed: C21.1, D4.2 (A), D5.1 (K)
unnamed: C21.2, Q7.2 (E), RV3.3
unnamed: C22.1, D2.1 (K), D2.2 (A), D3.1 (K), R25.2, TP8.1
unnamed: C22.2, Q8.1 (B), R27.1, R28.2
unnamed: C23.1, R44.2
unnamed: C23.2, C29.2
unnamed: C24.2, R26.1, R29.1, R30.2, RV2.3
unnamed: C26.1, Q8.3 (C), R30.1, U8.1 (OUT), U9.8 (Vcc)
unnamed: C27.2, C34.1, R32.1, R38.2, U1.8 (V+)
unnamed: C28.1, C35.1, C36.1, R32.2, R33.1, R34.2, R35.1, R36.1, U1.3 (+), U1.5 (+)
unnamed: C29.1, C30.1, R34.1, Y1.1
unnamed: C30.2, C31.1, C32.2, R35.2, R36.2
unnamed: C31.1, R29.2
unnamed: C31.2, C38.1, Q13.4 (G1), R37.1, R39.1, R73.1, U1.7
unnamed: C32.1, R37.2, R137.2, T10.1, U1.6 (-)
unnamed: C33.1, U14.6 (CLK2)
unnamed: C33.2, C61.2, RV13.3 (t)
unnamed: C35.2, Q18.3 (G2), R25.1, R39.2, R40.1
unnamed: C36.1, RV5.2
unnamed: C36.2, R40.2, R41.1, R43.1
unnamed: C37.1, R43.2, U1.2 (-)
unnamed: C37.2, C38.2, R42.1, U1.1
unnamed: C38.1, Q4.1 (B), R12.1, R13.2
unnamed: C40.2, Q8.2 (E), R31.2, T10.4, TP9.1
unnamed: C41.1, C44.1, L6.2, R96.2, R101.2
unnamed: C43.1, R106.1, T2.5 (SB)
unnamed: C43.2, D2.2 (A), R106.2
unnamed: C45.1, C49.2, D2.1 (K), R36.2, R37.1, R43.2
unnamed: C49.1, D2.2 (A), R43.1, U13.3 (+)
unnamed: C50.2, R35.1, R56.2, RV15.3 (t), U3.3 (+)
unnamed: C51.1, R38.2, U13.1, U13.5 (+)
unnamed: C55.2, R31.2
unnamed: C57.1, D2.2 (A), R113.2
unnamed: C57.2, R113.1, T2.3 (SA)
unnamed: C64.1, X1.3 (RFout)
unnamed: C64.2, U14.2 (XA)
unnamed: C65.1, J4.1
unnamed: C65.2, L5.1, R156.1
unnamed: C67.1, Q13.1 (S), R140.1
unnamed: C69.2, Q10.3 (G2), R63.1
unnamed: C70.1, L10.1, R64.2
unnamed: C70.2, Q11.4 (G1), R66.2
unnamed: C71.1, R42.2, R71.1, T8.2 (AB)
unnamed: C72.2, Q7.3 (C)
unnamed: C73.2, Q11.3 (G2), R68.2
unnamed: C74.2, R67.2, U6.1, U6.5 (+)
unnamed: C75.1, C83.1, C84.1, C94.1, C97.1, R49.1, R69.2, R70.1, R72.1, R75.1, R98.1, U7.3 (+), U7.5 (+), U10.3 (+), U10.5 (+)
unnamed: C76.1, C77.2, R72.2
unnamed: C77.1, C78.2, C79.2, R49.2, R75.2
unnamed: C78.1, R79.1, R84.1, SW1.3 (D1), U7.1
unnamed: C79.1, R79.2, U7.2 (-)
unnamed: C80.1, Q18.4 (G1), R19.2
unnamed: C81.2, J5.R, J5.RN, L17.2
unnamed: C83.2, R84.2, R85.1
unnamed: C84.2, R85.2, R86.2, R87.1
unnamed: C87.1, R87.2, U7.6 (-)
unnamed: C87.2, R86.1, R88.1, SW1.4 (D2), U7.7
unnamed: C89.2, U11.2 (BYPASS), U11.3 (INP)
unnamed: C91.2, Q14.4 (G1), R47.2
unnamed: C92.1, C93.1, T4.2
unnamed: C92.2, C93.2, Y3.1
unnamed: C94.2, R88.2, R89.1
unnamed: C95.1, D1.2 (A), R109.1, R110.1
unnamed: C96.1, C98.1, Y3.2, Y4.1
unnamed: C97.2, R89.2, R92.2, R94.1
unnamed: C100.1, C183.1, R95.2, U10.8 (V+)
unnamed: C101.1, C103.1, Y4.2, Y5.1
unnamed: C102.1, C113.2, R92.1, SW1.5 (D3), U10.1
unnamed: C102.2, R94.2, U10.2 (-)
unnamed: C104.1, Q10.1 (S), R110.2
unnamed: C105.2, T6.2, Y9.1
unnamed: C106.1, Y5.2
unnamed: C106.2, C108.2, C110.2, C112.2
unnamed: C48.2, C109.2, U11.6 (VDD), U15.3 (VO)
unnamed: C111.1, C166.2, C196.2, U12.1 (OUT), U14.1 (VDD), U14.7 (VDDO), X1.4 (VDD)
unnamed: C112.1, Y6.1
unnamed: C113.1, R97.1
unnamed: C114.1, T7.2, Y13.2
unnamed: C115.1, J7.2
unnamed: C116.1, C117.1, Y6.2, Y7.1
unnamed: C118.1, R100.1, SW1.6 (D4), U10.7
unnamed: C118.2, C120.2, R97.2, R98.2
unnamed: C119.1, C121.1, Y7.2, Y8.1
unnamed: C120.1, R100.2, U10.6 (-)
unnamed: C123.1, C124.1, T5.2
unnamed: C123.2, C124.2, Y8.2
unnamed: C125.1, C178.2, Y11.1
unnamed: C126.1, C179.1, C180.1
unnamed: C68.1, C130.1, R65.2, U6.8 (V+)
unnamed: C80.2, C131.1, D2.1 (K), L16.1
unnamed: C131.2, R20.1
unnamed: C132.1, C133.1, C188.1, C211.1, J16.2, J19.1, J19.2, J19.3, J19.4, L12.1
unnamed: C27.1, C135.1, C197.1, R90.1, U19.2 (-)
unnamed: C27.2, C135.2, C197.2, R62.1, R91.2, U19.1
unnamed: C136.1, Q11.1 (S), R111.2
unnamed: C54.1, C137.1, C155.1, POT3.1 (b), POT3.2 (wip), POT4.2
unnamed: C88.2, C138.1, C194.2, U9.4 (OUT_A)
unnamed: C139.1, Q6.3 (C), R116.1, T3.4 (SC)
unnamed: C140.1, Q6.1 (B), R41.1, TP5.1, U13.7
unnamed: C141.1, R51.2
unnamed: C146.1, U14.10 (CLK0)
unnamed: C146.2, C207.2, R78.2
unnamed: C147.1, R118.2, R120.1, T11.1
unnamed: C148.2, Y1.2, Y2.1
unnamed: C149.1, R149.1
unnamed: C149.2, R54.2, R60.2, U5.5 (+)
unnamed: C150.1, Q1.2 (E), R146.1
unnamed: C150.2, R145.1
unnamed: C152.1, POT4.1, R46.1, U3.5 (+), U5.3 (+)
unnamed: C56.1, C153.1, C208.2, R127.2, U5.2 (-)
unnamed: C56.2, C153.2, R138.2
unnamed: C154.1, J13.2
unnamed: C154.2, C199.2, R157.2
unnamed: C156.1, D14.2 (A), R66.1, R111.1
unnamed: C160.1, L7.2, R143.1
unnamed: C161.1, J15.2
unnamed: C74.1, C76.2, C161.2, SW1.2 (D0)
unnamed: C162.1, Q9.1 (B), Q12.1 (B), R134.2, R135.1
unnamed: C162.2, L11.1, R74.1
unnamed: C165.1, Y9.2, Y10.1
unnamed: C168.1, X2.3 (RFout)
unnamed: C168.2, U17.2 (XA)
unnamed: C169.1, C170.1, U16.1 (OUT), U17.1 (VDD), U17.7 (VDDO), X2.4 (VDD)
unnamed: C25.1, C37.1, C171.1, C219.1, POT6.8
unnamed: C25.2, C37.2, C171.2, POT6.4, POT6.5, R123.2, U18.7
unnamed: C172.1, Q4.2 (E), R144.1
unnamed: C172.2, R147.1
unnamed: C175.1, D22.2 (A), D23.1 (K), T8.3 (SA)
unnamed: C175.2, U9.2 (IN_B)
unnamed: C22.2, C177.1, IFt2.5
unnamed: C18.2, C177.2, IFt2.3, R14.2
unnamed: C178.1, Y10.2
unnamed: C179.2, Y12.1
unnamed: C180.2, Y11.2
unnamed: C82.1, C182.1, R82.2, U7.8 (V+)
unnamed: C66.1, C184.1, R58.2, R59.1, R61.1
unnamed: C185.1, Y12.2, Y13.1
unnamed: C88.1, C90.1, C194.1, U9.5 (OUT_B)
unnamed: C36.2, C198.1, POT7.2 (wip)
unnamed: C198.2, R23.2, R200.2
unnamed: C199.1, R99.1, U19.7
unnamed: C200.1, SW1.1 (CM), TP7.1
unnamed: C200.2, R102.2
unnamed: C201.2, R122.2
unnamed: C202.2, R107.2, R124.1, U18.5 (+), U19.3 (+), U19.5 (+)
unnamed: C206.1, R78.1, R80.2
unnamed: C208.1, D2.1 (K), R126.2, R127.1, U5.1
unnamed: C209.1, TP11.1, U6.6 (-), U6.7
unnamed: C209.2, R148.2
unnamed: C210.1, D5.2 (A), R153.1
unnamed: C212.1, D22.1 (K), D23.2 (A), T8.5 (SB)
unnamed: C212.2, U9.1 (IN_A)
unnamed: C213.2, Q14.3 (G2), R178.1
unnamed: C214.1, D24.2 (A), R47.1, R177.1
unnamed: C216.1, Q13.3 (G2), R141.2, R151.1, R152.1
unnamed: C217.1, Q5.3 (C), R154.2, R155.1
unnamed: C218.1, Q5.1 (B), R158.1
unnamed: C219.2, POT6.7, R83.1, U18.6 (-)
unnamed: C224.1, RV8.1 (b)
unnamed: C225.1, R157.1, R159.2, RV8.3 (t)
unnamed: C231.1, Q12.2 (E), R76.1
unnamed: C233.1, L9.1, R112.2
unnamed: C233.2, Q10.4 (G1), R109.2
unnamed: C234.1, Q14.1 (S), R177.2
unnamed: C245.1, Q9.2 (E), R139.1
unnamed: C246.1, R205.2, R206.1
unnamed: D1.1 (K), D15.2 (A)
unnamed: D1.2 (A), R17.1
unnamed: D2.1 (K), D2.2 (A), R125.1, T1.5 (SB), T3.3 (SA), T3.5 (SB), U3.7
unnamed: D2.2 (A), POT4.4, R128.1
unnamed: D3.2 (A), T1.3 (SA)
unnamed: D7.2 (A), D8.1 (K), DBM1.1, J9.1 (In)
unnamed: D14.1 (K), D17.2 (A)
unnamed: D18.2 (A), R129.1
unnamed: D19.2 (A), R131.1
unnamed: D20.2 (A), R136.1
unnamed: D5.1 (K), D21.2 (A)
unnamed: D24.1 (K), D25.2 (A)
unnamed: DBM1.5, R13.2, R15.2
unnamed: IFt1.4, R7.1
unnamed: IFt2.4, R12.1
unnamed: J1.1, J3.3, J22.S, J26.1, U11.8 (VO2)
unnamed: J1.2, J22.TN, J26.2
unnamed: J4.2, R1.2
unnamed: J6.3, U17.5 (SDA)
unnamed: J6.4, U17.4 (SCL)
unnamed: J10.1, R22.1, R26.2, R45.2, U11.5 (VOi)
unnamed: J3.1, J10.2, J22.T, R26.1, R45.1
unnamed: J11.1 (In), U17.9 (CLK1)
unnamed: J19.7, JP1.3 (B)
unnamed: J19.9, R204.2
unnamed: J3.2, J22.R
unnamed: JP1.1 (A), Q24.3 (D)
unnamed: K1.3, K1.6, K3.3, K3.6
unnamed: K2.3, K2.6, K4.3, K4.6
unnamed: K3.2, K3.7, T4.1
unnamed: K3.4, K3.5, T6.3
unnamed: K4.2, K4.7, T5.3
unnamed: K4.4, K4.5, T7.1
unnamed: L8.2, R117.1
unnamed: POT1.2, R3.1, R11.2
unnamed: POT1.3, R1.2
unnamed: POT1.4, R1.1, R8.1, R14.1, R128.2
unnamed: POT3.3 (t), R35.2
unnamed: POT4.5, R56.1
unnamed: POT6.1, POT6.2, R55.2, R81.1, U18.1
unnamed: POT6.3, R83.2
unnamed: POT6.6, R90.2
unnamed: POT7.3 (t), R159.1, RV8.2 (wip)
unnamed: Q1.3 (C), R3.2, RV1.3
unnamed: Q2.2 (E), R7.2, R9.2
unnamed: Q2.3 (C), T1.2 (AB)
unnamed: Q3.1 (B), Q5.2 (E), R15.2, R17.2
unnamed: Q3.2 (E), R12.2
unnamed: Q5.2 (E), R156.2
unnamed: Q5.3 (C), R16.1
unnamed: Q5.4 (G1), R31.1, R32.1
unnamed: Q6.3 (C), Q7.1 (B), R18.2, R21.1
unnamed: Q7.1 (B), R53.1, R132.1
unnamed: Q7.3 (C), R24.1
unnamed: Q8.1 (B), R52.1, R57.2
unnamed: Q8.3 (C), RV15.1 (b), RV15.2 (wip)
unnamed: Q10.2 (D), R64.1
unnamed: Q11.2 (D), R42.1, T8.1 (AA), TP1.1
unnamed: Q9.3 (C), Q12.3 (C), R134.1, T10.2
unnamed: Q13.2 (D), R74.2
unnamed: Q14.2 (D), R112.1
unnamed: Q18.1 (S), R19.1, R153.2
unnamed: Q18.2 (D), R120.2, T11.2
unnamed: Q24.1 (G), R201.2, R202.1
unnamed: Q25.1 (G), R203.2, R204.1
unnamed: R21.2, RV14.1 (b)
unnamed: R24.2, R28.1, U13.2 (-)
unnamed: R27.1, RV14.2 (wip)
unnamed: R34.2, R61.2, U6.3 (+)
unnamed: R39.2, R40.1, U13.6 (-)
unnamed: R41.2, R42.2
unnamed: R44.1, RV3.2
unnamed: R51.1, RV12.2 (wip), RV12.3 (t), U5.6 (-)
unnamed: R55.1, R91.1, R99.2, U19.6 (-)
unnamed: R62.2, R81.2, R102.1, U18.2 (-)
unnamed: R104.1, R105.2, T2.4 (SC)
unnamed: R67.1, R108.2, U6.2 (-)
unnamed: R122.1, R123.1, U18.3 (+)
unnamed: R125.2, R126.1, U3.6 (-)
unnamed: R138.1, RV12.1 (b), U5.7
unnamed: R142.2, RV13.2 (wip)
unnamed: R33.1, R148.1, R149.2
unnamed: R46.2, R150.1
unnamed: R22.2, R23.1, R200.1, U11.4 (INN)
unnamed: T2.2 (AB), Y2.2
PTT: C5.2, J19.12, L2.1
SCL: J19.6, U14.4 (SCL)
SDA: J19.8, U14.5 (SDA)
Sidetone: J19.16, RV5.3
TX_Feed: C40.1, D2.2 (A), L8.1

Notes on the sheet:
To U9 pin 6 250mVpp
R97 sets gain
Must be on (hi) for RX
To SSB Filter
125 mVpp
10dB Attenuator 100R in 50R out
LO TCXO
1. Adjust for S0 with no signal at antenna and S1 with -107dBm
This VCO Buffer is under change.
Noise Blanker
Noise Blanker Switch
From SSB Filter
Audio AGC feed
(++=20k)
AGC Decay
8MHz -20dBm on SA 126mV on scope NOT MORE
From Q18 RF Amp above
Speaker / Phones Configuration NONE of the AMP connections allowed to ground.
RF Amplifier
TX DSB IN
3kHz Low Pass
+7dbm 1.4Vpp when DBM not fitted
68R with 12t 0.32mm wound on top
CPU Over voltage protect
10:10:10 10+10pri bif 10t sec
3.6V
Notes: - mVpp Test voltages with AGC off - Hand = Hand fitted - sc = Short Circuit - oc = Open Circuit - nf = Not Fitted
(SSB RX/TX)
S-mtr_cal Zero
Audio Notch Filter
2. AGC Gain Adjust for S9 with -73dBm at antenna
-20dBm SSB
O/P to NANO
(//=9k1)
F1 Either a single 2 pole 3 pin filter or 2 x xtals + 33pf
TX IF buffer, Amp SSB & CW
-20dBm
DSB Out to filter 8MHz xxx dBm xxx mV pp
This TX Buffer is under change.
Narrow CW Filter(optional)
This design by Michael Wise while Open-Sourcesd does come with conditions. The project is open for contributers and is not for freely ripping off and selling as a product. That is theft. See the conditions and comply to them as laid out on GitHub.
Wiper off SSB1 SSB2 SSB3 CW
Optional IF output. Rear pannel connection BNC for Waterfall etc
BFO/TXO/CW TCXO
Note: 13.8V for testing
SSB Filter
Volume
To Q5 Base Adj at Mixer output -10dBm
Noise Blanker / Woodpecker filter Balanced switch
-15dBm SSB & CW
Test figures at -20dBm in
NB off
AGC Amp & Detector
Note: -Resonant at IF frequency. -If TOKO 4520 used for IFT1 & IFT2 do not fit C176 & C277 -Centre Tap IS required
Mixer ADE-1 or SBL-1
Audio filter
40 mVpp
Diplexer
RX IF
AGC Off
Spectrum = 820 Other as per spec.
CF=1350HZ SSB offset=1500HZ
When NB is on, AGC on Front End is forced maximum gain, 5V.
Adjust to remove CW clicks in TX
or Speaker
90 mVpp
Tone Option. 10k pot C225=3n3 C224=22n Remove R159
MIC/PTT Plug on Front Panel 4 Pin 1=gnd, 2=mic 3=ptt, 4=n/c
Audio Buffer
300Hz High Pass
Iss 7 SM April 2024 Last modified 28 / 04 / 2024
To SSB/CW Filter
16:7 2500r:500r
To U6 Audio buffer below
IF Gain
Noise Blanker / Woodpecker wideband RF AMP
Option o/c 8 Ohm s/c 4 Ohm
VHF Termination
Option to test TX as NOT RX
250 mVpp (Min200, Max300)
From TX IF Amp below
5.2V
i/p -15dbm max, 40mvpp for o/p 1Vpp. (Added) Gain 14-19db.
4.3V
33pf
Noise Blanker / Woodpecker detector and switch
TX SSB OUT
8:4+4
IF Amplifier
Audio Detector
